pinballwizz/EBAZ4205-Arcade/README.md

# EBAZ4205 Arcade
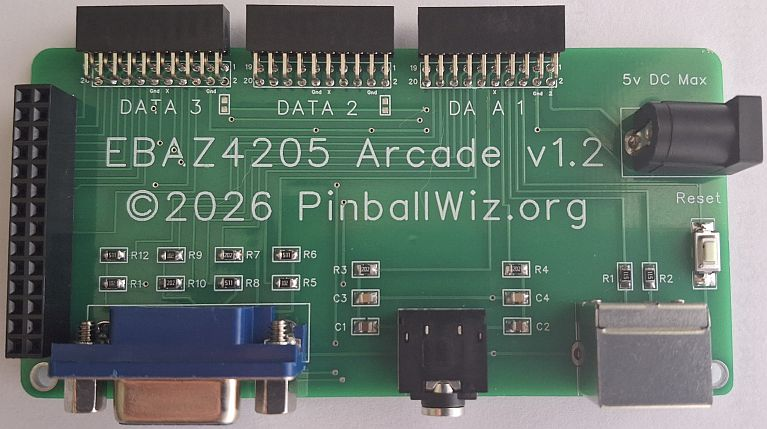
[picture p1: EBAZ4205-Arcade.jpg]

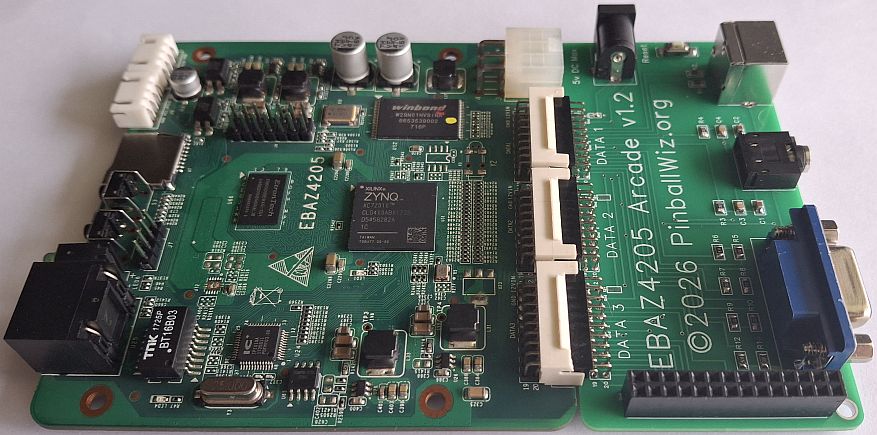
[picture p2: EBAZ4205_Arcade.jpg]


This project has now been updated and replaced by the ZYNQ Arcade Project here:  

https://github.com/pinballwizz/ZYNQ-Arcade  

This project has now been kept for archival purposes only.  

EBAZ4205 Arcade PCB for the EBAZ4205 ZYNQ 7010 FPGA Board.  
Features 8 Bit VGA, PS2 Keyboard and 2 channel Audio.  
PinballWiz.org 2026
