pinballwizz/EBAZ4205-Arcade/EBAZ4205-Arcade/constraints/readme.txt

Constraints file to use in conjunction with the EBAZ-4205 Arcade PCB and Vivado.
