pinballwizz/EBAZ4205-Arcade/EBAZ4205-Arcade/docs/schematics/audio.jpg

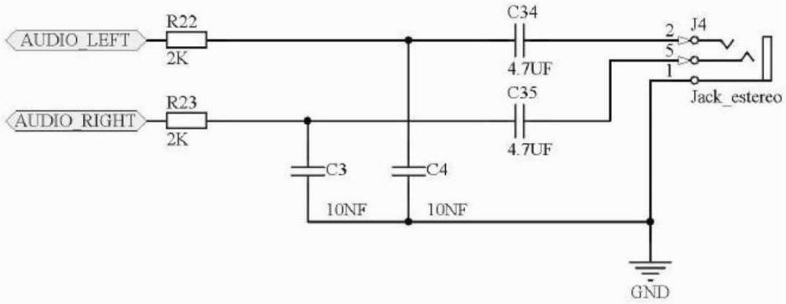
EBAZ4205-Arcade/docs/schematics/audio.jpg
