pinballwizz/EBAZ4205-Arcade/EBAZ4205-Arcade/docs/schematics/EBAZ4205-Pinouts.jpg

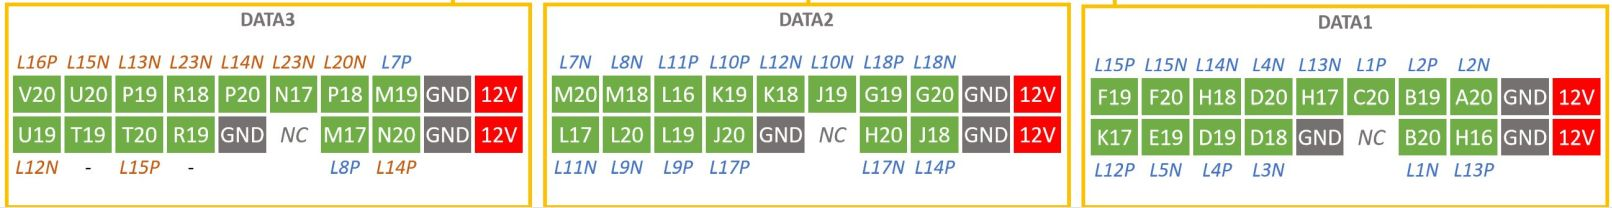
EBAZ4205-Arcade/docs/schematics/EBAZ4205-Pinouts.jpg
