pinballwizz/EBAZ4205-Arcade/EBAZ4205-Arcade/docs/schematics/PS2-keyboard.jpg

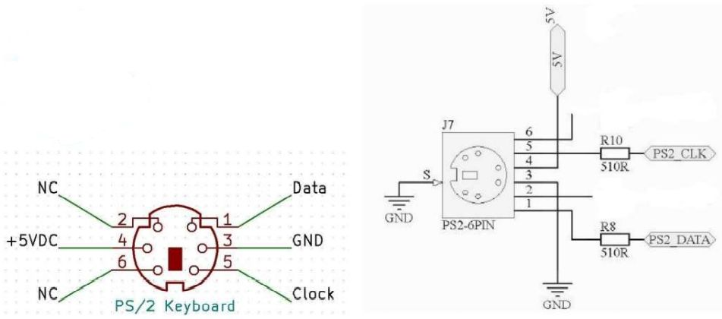
EBAZ4205-Arcade/docs/schematics/PS2-keyboard.jpg
