pinballwizz/EBAZ4205-Arcade/EBAZ4205-Arcade/docs/schematics/vga.jpg

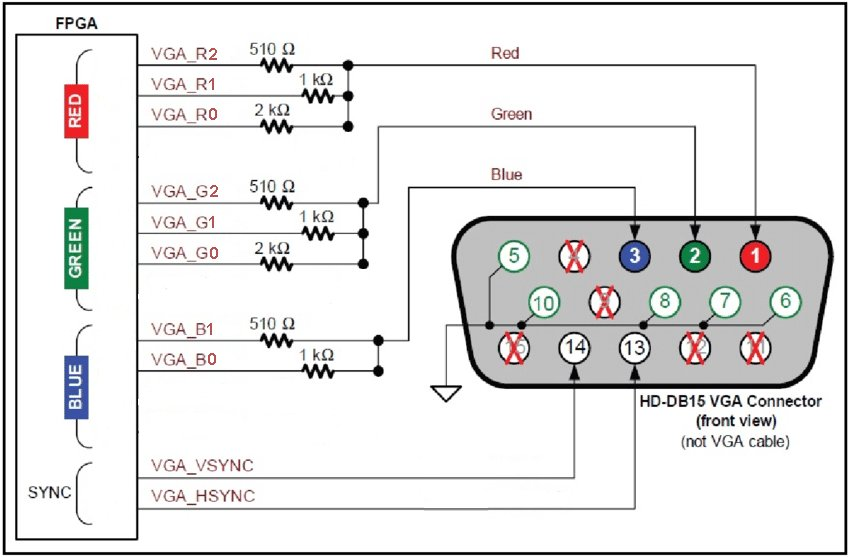
EBAZ4205-Arcade/docs/schematics/vga.jpg
